rixnobis/ps1-port-tap/renders/3d-bottom.png

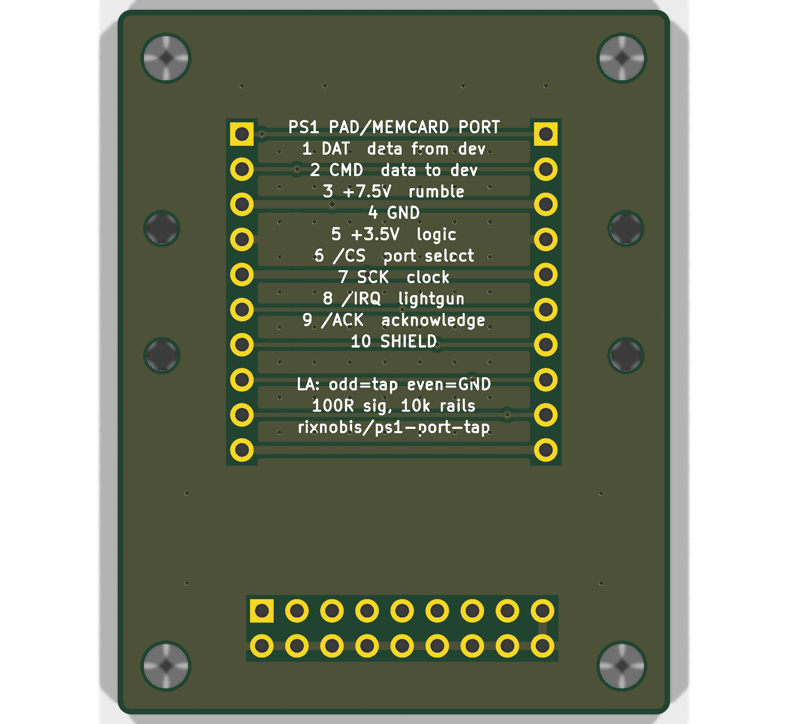
renders/3d-bottom.png
