rixnobis/ps1-port-tap/renders/B.Cu.png

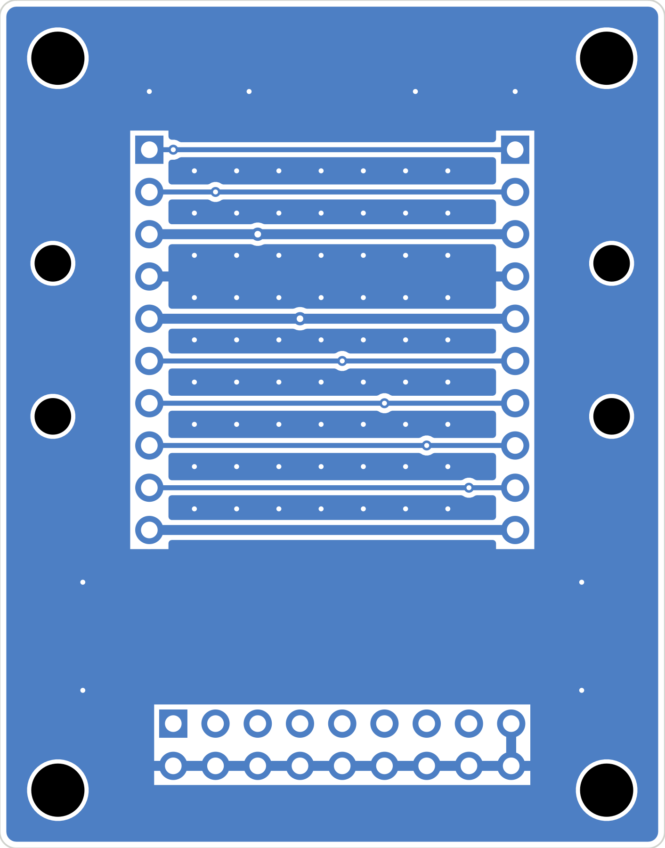
renders/B.Cu.png
