rixnobis/ps1-port-tap/renders/B.SilkS.png

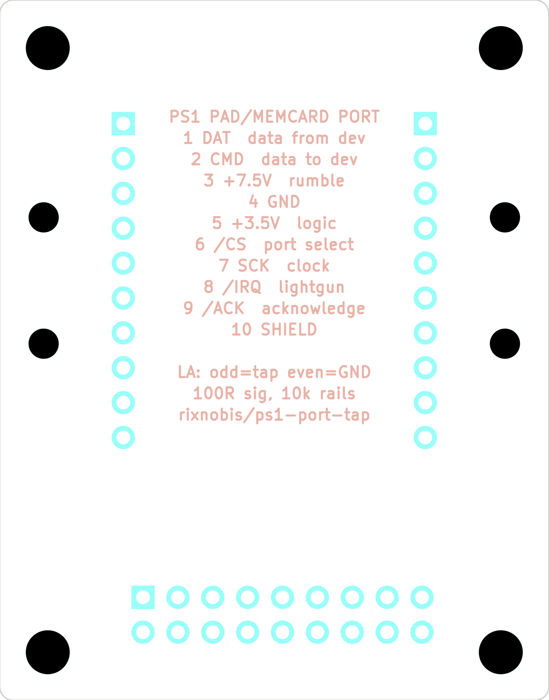
renders/B.SilkS.png
