rixnobis/ps1-port-tap/renders/composite.png

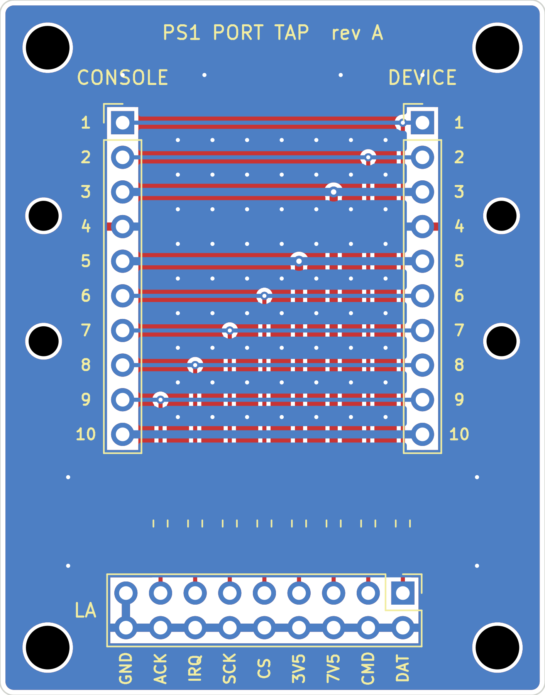
renders/composite.png
