rixnobis/ps1-port-tap/renders/crops/J1-pins1-5.png

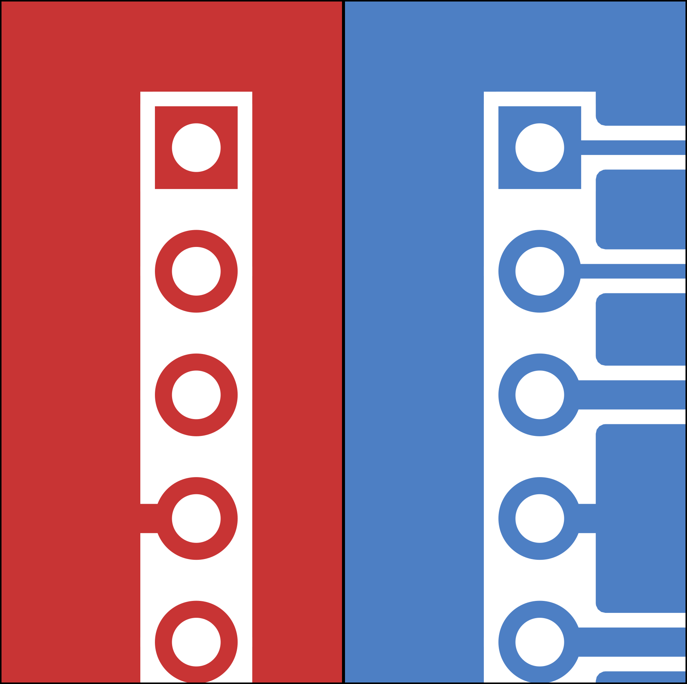
renders/crops/J1-pins1-5.png
