rixnobis/ps1-port-tap/renders/crops/J1-pins6-10.png

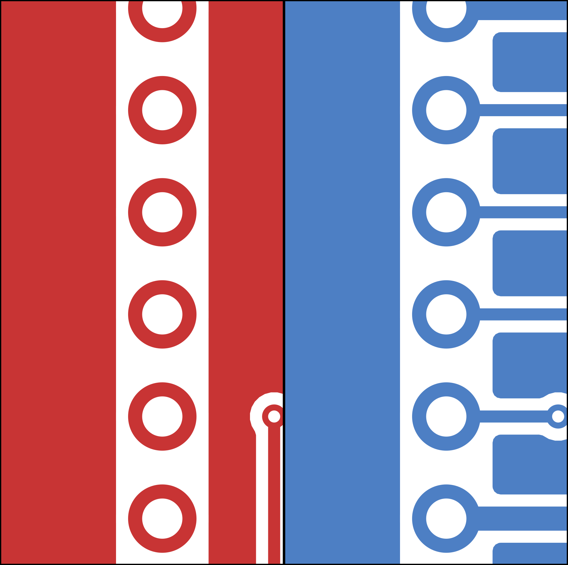
renders/crops/J1-pins6-10.png
