rixnobis/ps1-port-tap/renders/crops/J2-pins1-5.png

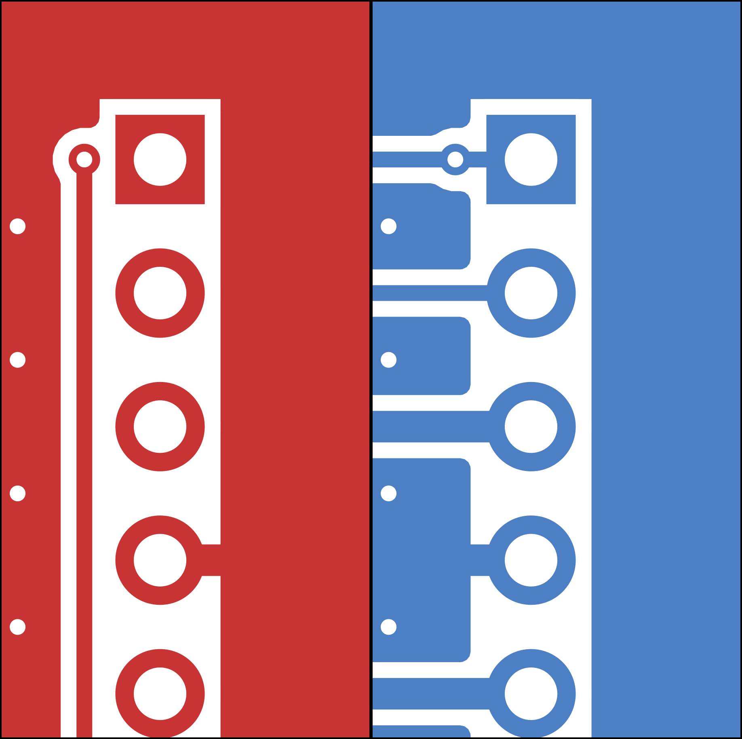
renders/crops/J2-pins1-5.png
