rixnobis/ps1-port-tap/renders/crops/R-J3-left.png

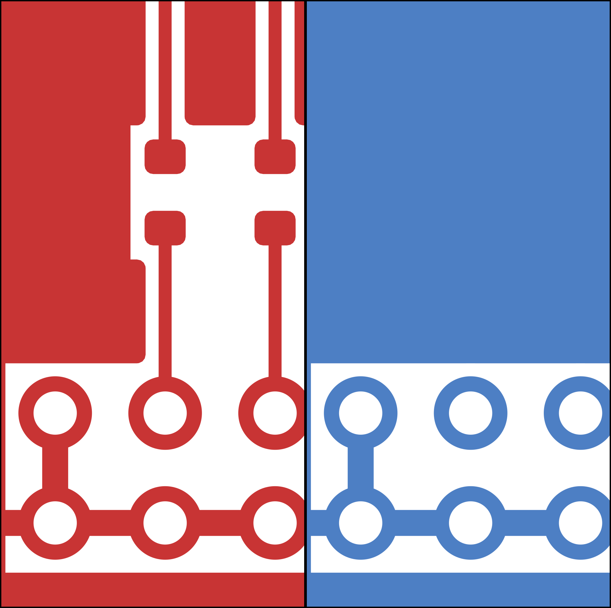
renders/crops/R-J3-left.png
