rixnobis/ps1-port-tap/renders/crops/R-J3-midL.png

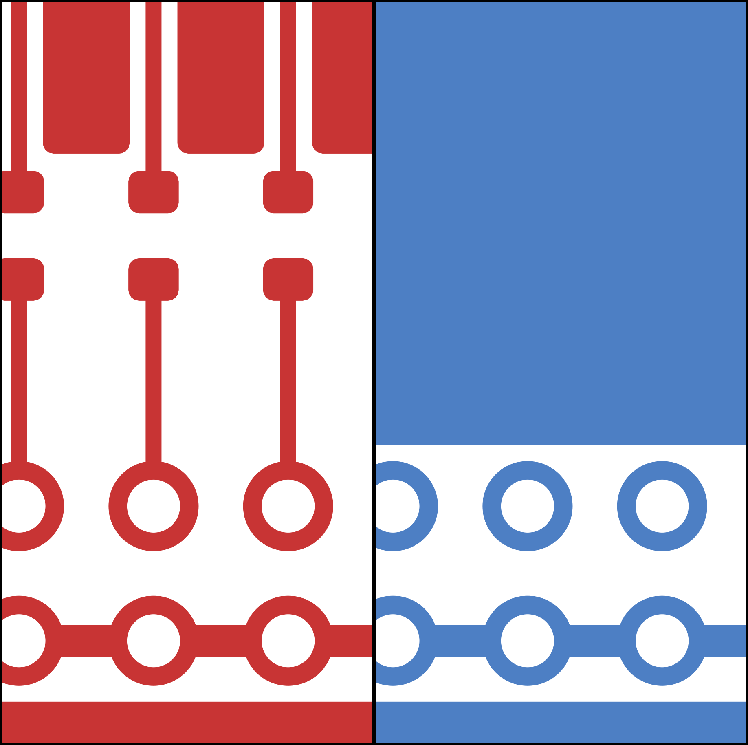
renders/crops/R-J3-midL.png
