rixnobis/ps1-port-tap/renders/crops/R-J3-midR.png

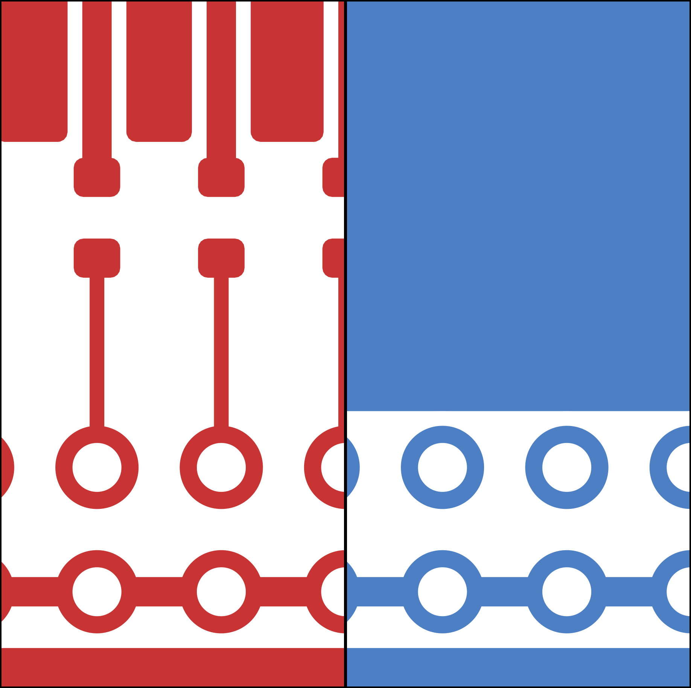
renders/crops/R-J3-midR.png
