rixnobis/ps1-port-tap/renders/crops/R-J3-right.png

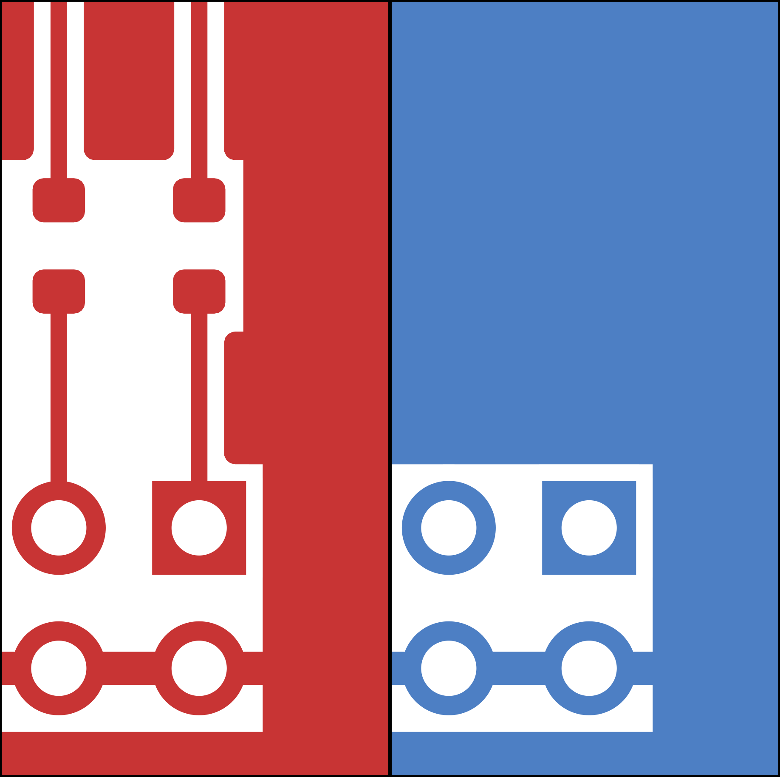
renders/crops/R-J3-right.png
