rixnobis/ps1-port-tap/renders/F.Cu.png

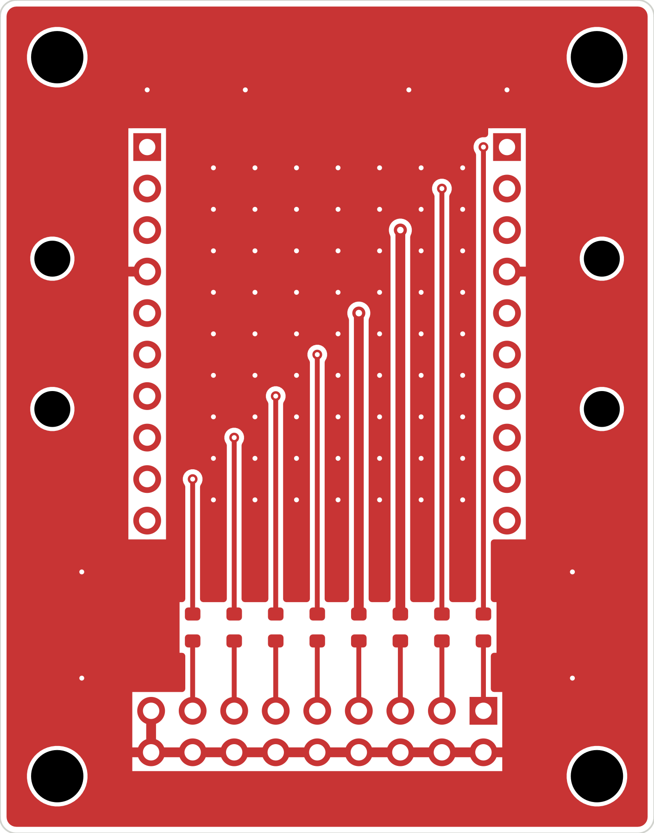
renders/F.Cu.png
