rixnobis/ps1-port-tap/renders/F.SilkS.png

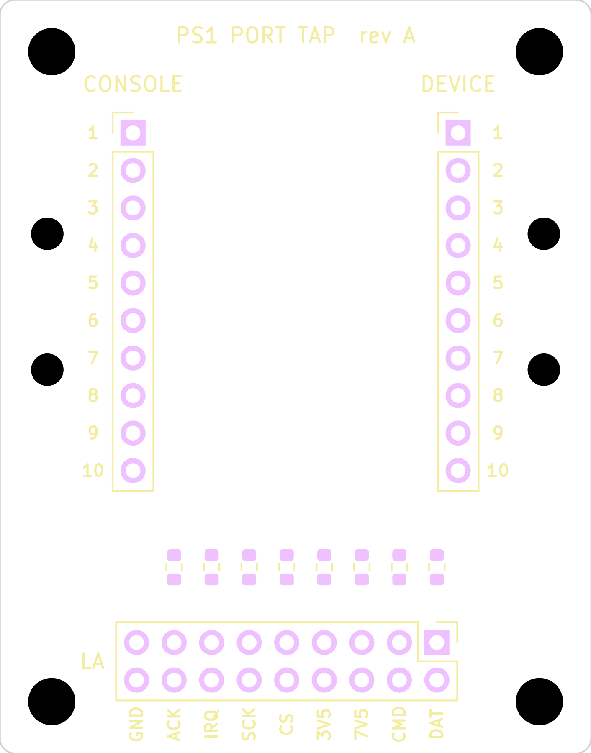
renders/F.SilkS.png
