rixnobis/ps1-port-tap/fab/ps1-port-tap-bom.csv

Comment | Designator | Footprint | LCSC Part #
100 | R1,R2,R5,R6,R7,R8 | Resistor_SMD:R_0603_1608Metric | C22775
10k | R3,R4 | Resistor_SMD:R_0603_1608Metric | C25804
