rixnobis/ps1-port-tap/schematic.pdf

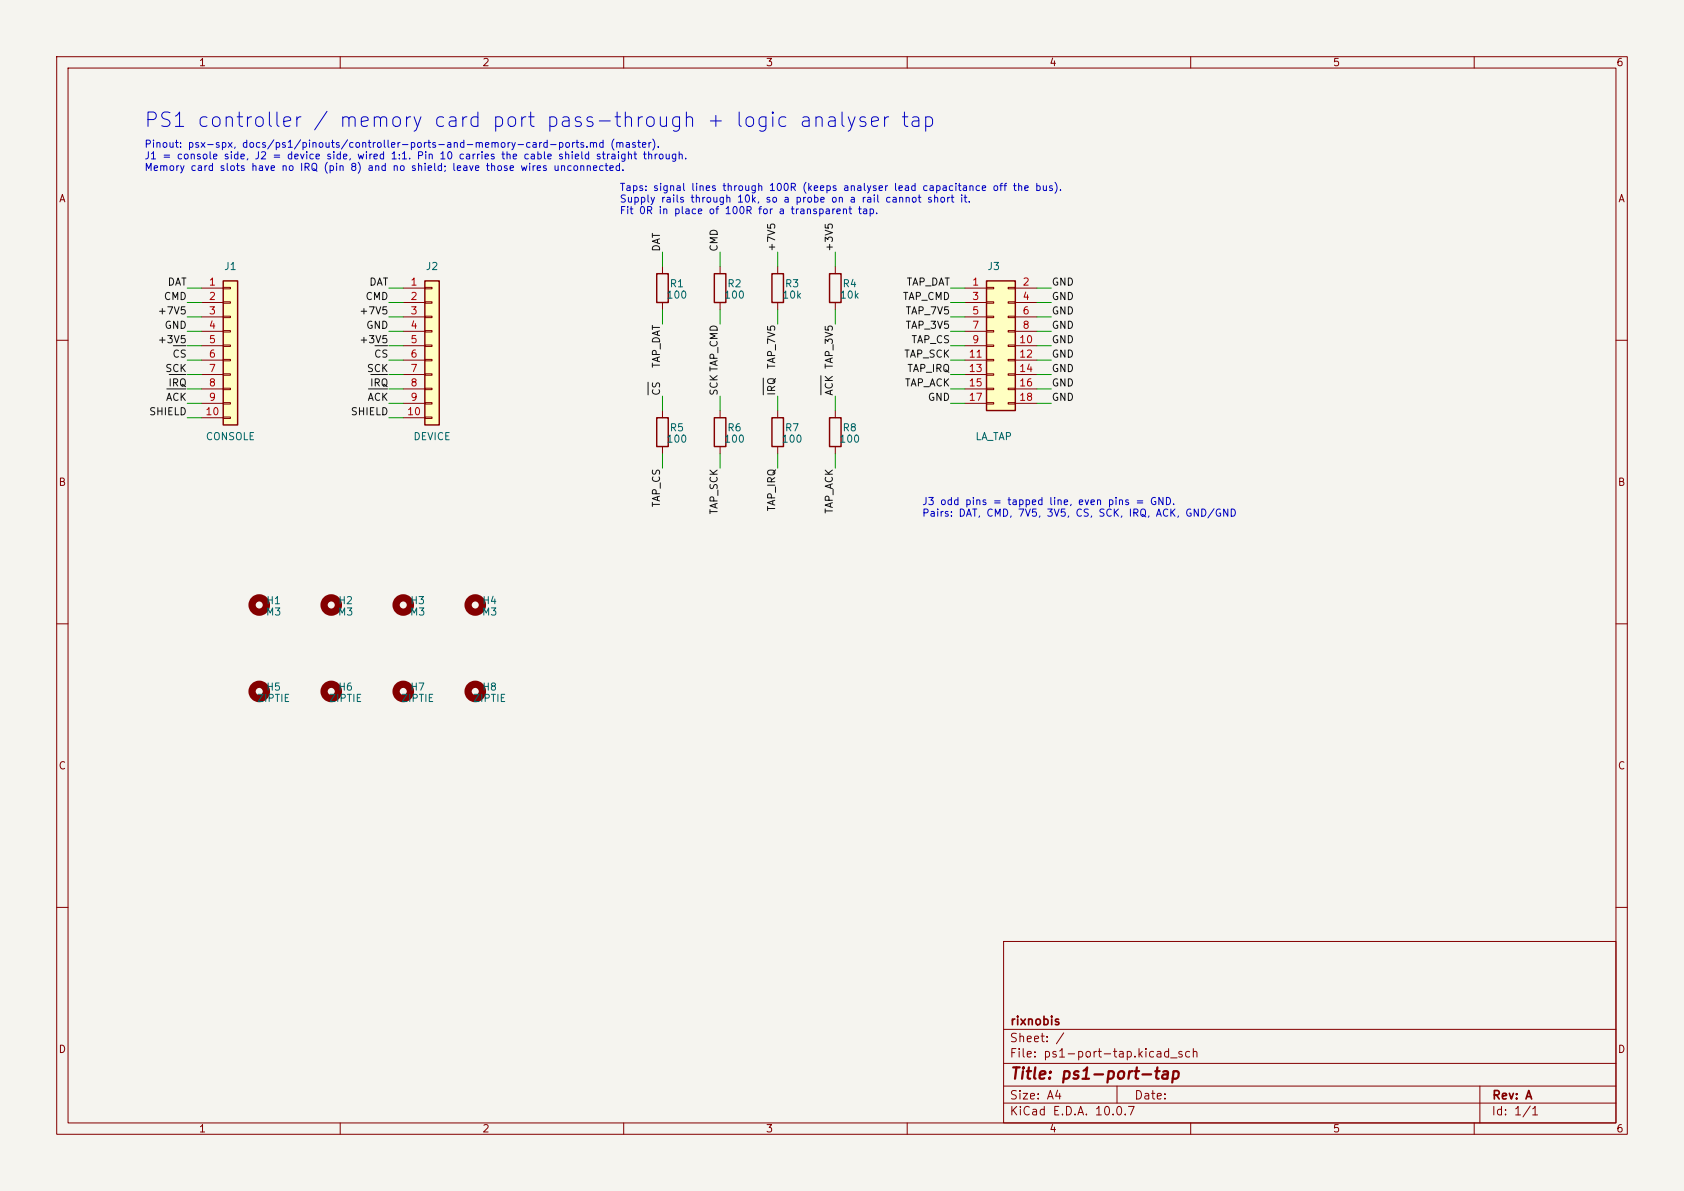
[picture p15: page 1]

GND PS1 controller / memory card port pass-through + logic analyser tap

Supply rails through 10k, so a probe on a rail cannot short it. Fit 0R in place of 100R for a transparent tap. Pinout: psx-spx, docs/ps1/pinouts/controller-ports-and-memory-card-ports.md (master). J1 = console side, J2 = device side, wired 1:1. Pin 10 carries the cable shield straight through.

Taps: signal lines through 100R (keeps analyser lead capacitance off the bus).

Size: A4 | Rev: A
KiCad E.D.A. 10.0.7 | Id: 1/1
