rixnobis/ps1-port-tap/ps1-port-tap.kicad_pcb

## KiCad design ps1-port-tap.kicad_pcb (2026-10-21)

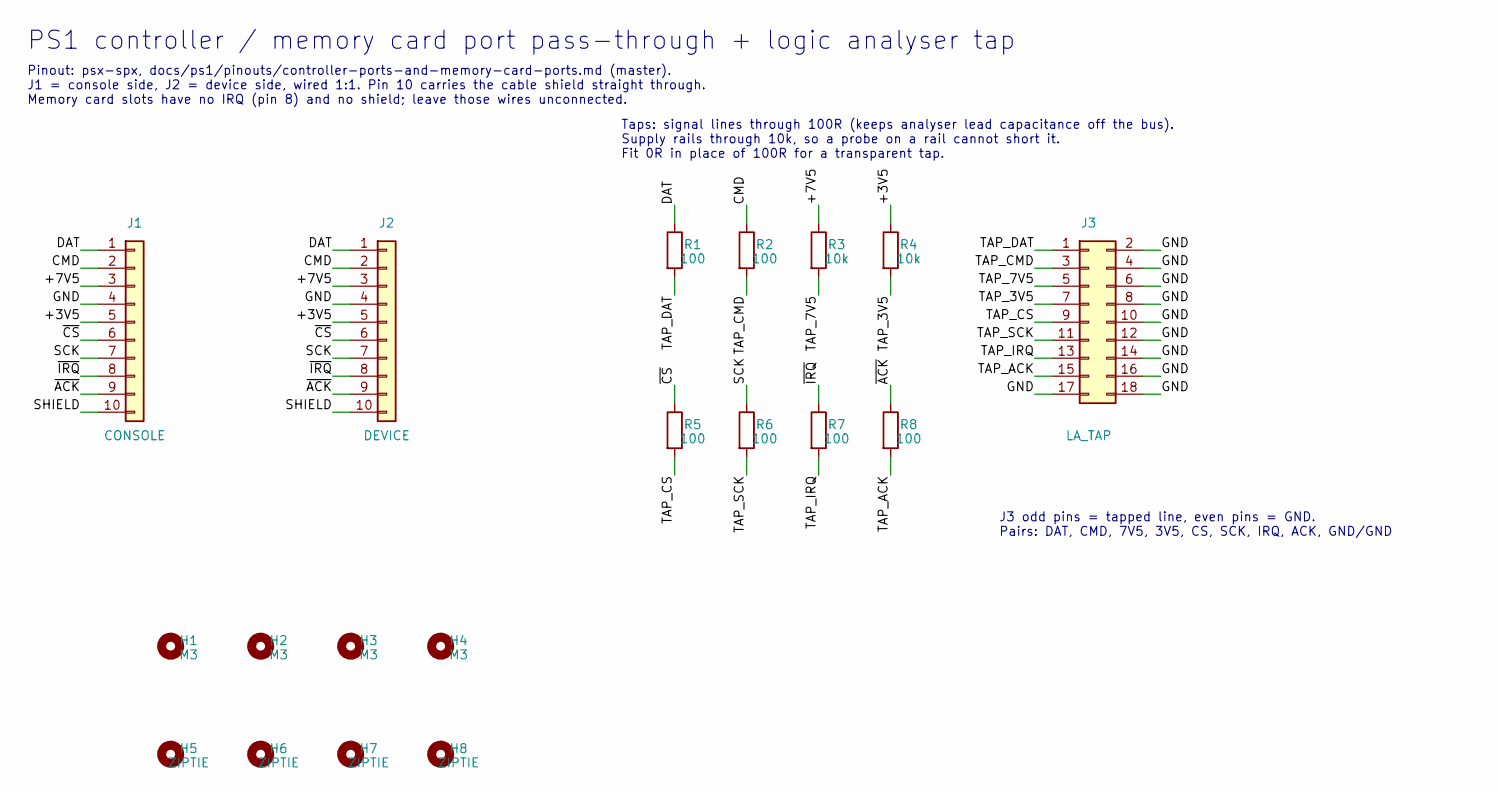
[picture p16: schematic ps1-port-tap.kicad_sch]

Parts:
H1, H2, H3, H4: M3; MountingHole_3.2mm_M3
H5, H6, H7, H8: ZIPTIE; MountingHole_2.2mm_M2
J1: CONSOLE; PinHeader_1x10_P2.54mm_Vertical
J2: DEVICE; PinHeader_1x10_P2.54mm_Vertical
J3: LA_TAP; PinHeader_2x09_P2.54mm_Vertical
R1, R2, R5, R6, R7, R8: 100; R_0603_1608Metric; LCSC C22775
R3, R4: 10k; R_0603_1608Metric; LCSC C25804

Connections:
/+3V5: J1.5, J2.5, R4.1
/+7V5: J1.3, J2.3, R3.1
/CMD: J1.2, J2.2, R2.1
/DAT: J1.1, J2.1, R1.1
/GND: J1.4, J2.4, J3.2, J3.4, J3.6, J3.8, J3.10, J3.12, J3.14, J3.16, J3.17, J3.18
/SCK: J1.7, J2.7, R6.1
/SHIELD: J1.10, J2.10
/TAP_3V5: J3.7, R4.2
/TAP_7V5: J3.5, R3.2
/TAP_ACK: J3.15, R8.2
/TAP_CMD: J3.3, R2.2
/TAP_CS: J3.9, R5.2
/TAP_DAT: J3.1, R1.2
/TAP_IRQ: J3.13, R7.2
/TAP_SCK: J3.11, R6.2
/~ACK: J1.9, J2.9, R8.1
/~CS: J1.6, J2.6, R5.1
/~IRQ: J1.8, J2.8, R7.1

Notes on the sheet:
PS1 controller / memory card port pass-through + logic analyser tap
Pinout: psx-spx, docs/ps1/pinouts/controller-ports-and-memory-card-ports.md (master). J1 = console side, J2 = device side, wired 1:1. Pin 10 carries the cable shield straight through. Memory card slots have no IRQ (pin 8) and no shield; leave those wires unconnected.
Taps: signal lines through 100R (keeps analyser lead capacitance off the bus). Supply rails through 10k, so a probe on a rail cannot short it. Fit 0R in place of 100R for a transparent tap.
J3 odd pins = tapped line, even pins = GND. Pairs: DAT, CMD, 7V5, 3V5, CS, SCK, IRQ, ACK, GND/GND

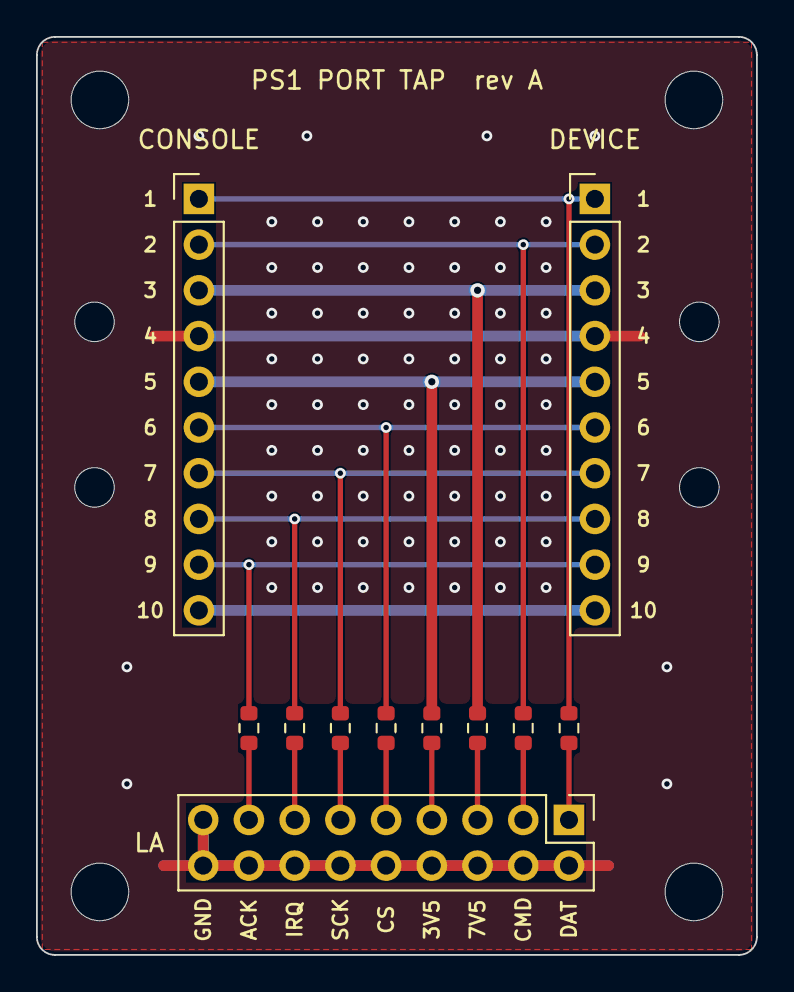
[picture p17: board ps1-port-tap.kicad_pcb from above]

Board: 2 copper layers, 40.0 x 51.0 mm, 19 parts (0 on the bottom side), 18 nets.
