rixnobis/ps1-port-tap/(commit log)

2026-10-21 PS1 port pass-through with logic analyser tap, rev A
    Pinout from psx-spx. Inline on a cut extension cable, since no trustworthy
    drawing of the port connector exists. tools/build.sh regenerates everything.
    [ps1-port-tap-B_Cu.gbr, ps1-port-tap-B_Mask.gbr, ps1-port-tap-B_Silkscreen.gbr, ps1-port-tap-Edge_Cuts.gbr, ps1-port-tap-F_Cu.gbr, ps1-port-tap-F_Mask.gbr, ps1-port-tap-F_Paste.gbr, ps1-port-tap-F_Silkscreen.gbr]
2026-10-21 Hand-route every run straight, keep pour out of pad rows
    Freerouting left 90-degree points, sub-width jogs and necked traces that DRC
    passes. Routing is now scripted and straight, the pour stops at the pad rows,
    and tools/check_geometry.py plus zoomed crops gate the build.
    [ps1-port-tap-B_Cu.gbr, ps1-port-tap-B_Mask.gbr, ps1-port-tap-B_Silkscreen.gbr, ps1-port-tap-Edge_Cuts.gbr, ps1-port-tap-F_Cu.gbr, ps1-port-tap-F_Mask.gbr, ps1-port-tap-F_Paste.gbr, ps1-port-tap-F_Silkscreen.gbr]
